pauldhawk/splitflap/docs/goals.md

# project roadmap

PCB Configuration Summary:
-  Display: 48 modules arranged as 4 rows × 12 modules/row
-  Driver Boards: 8 boards (2 per row) × 6 modules/board
-  Daisy Chain: RJ45 connectors with CAT5e/6 cable
-  Motor: NEMA 17 (17HS19-2004S1) with TMC2209 drivers
-  Microstepping: 1/16 (3200 steps/revolution)
-  Current: 1.0A RMS per motor
questions:
1. do you have the abilty to desin new pcb boards? I plan on having them fabricated and need to have a full design 
units:
- new disgn
- motor in the back
- new motor that is stronger
- wire organization
questions:
1. I will be updating the cad files to work with this model. do you have the ability to work with any cad files? like scad or fussion
2. 

I still have a bunch of base questions. This update needs:
1. updating the 3d section for the units (thiking about moving the motor behind the flaps but not sure)
2. 

  Quick Reference for Review

  Key Documents:
  - docs/Firmware_Motor_Selection.md - Firmware implementation (just created)
  - docs/NEMA17_TMC2209_Upgrade.md - Hardware design
  - docs/MotorControlLogic.md - Current motor control explanation

  Core Concepts:
  - Compile-time selection: Motor type chosen at build time via platformio.ini
  - 95% shared code: Only motor control differs between types
  - Zero overhead: Compiler removes unused code paths
  - Backward compatible: Existing 28BYJ-48 systems unaffected

  ---
  I'm Ready for Your Questions!

  Ask me anything about:
  - 🏗️ Architecture: Why this approach? What are the alternatives?
  - 🔧 Implementation: How does the code actually work?
  - 🔌 Hardware: How does firmware talk to TMC2209? Pin assignments?
  - ⚡ Performance: Timing, speed, resource usage?
  - 🧪 Testing: How to verify it works? What could go wrong?
  - 📚 Dependencies: What libraries needed? Tool versions?
  - ⏱️ Timeline: How long will implementation take?
  - 🎯 Scope: What's in phase 1 vs later phases?
  - 🤔 Edge Cases: Mixed systems? Upgrading firmware? Rollback?

  Go ahead - ask your base questions and I'll explain everything in detail!

  pleaser look at hte current cad files. thinking about:
  1. should we move the motor to being the drum (these motors with is veriable so it could simplify things or just make it work with the motor instide.
  2. other deisgn changes that will be needed.
  3. is 3d printing the base way to build the unit or some other method
