pauldhawk/splitflap/3d/redesign/nema17_coupling_hub_preview.png

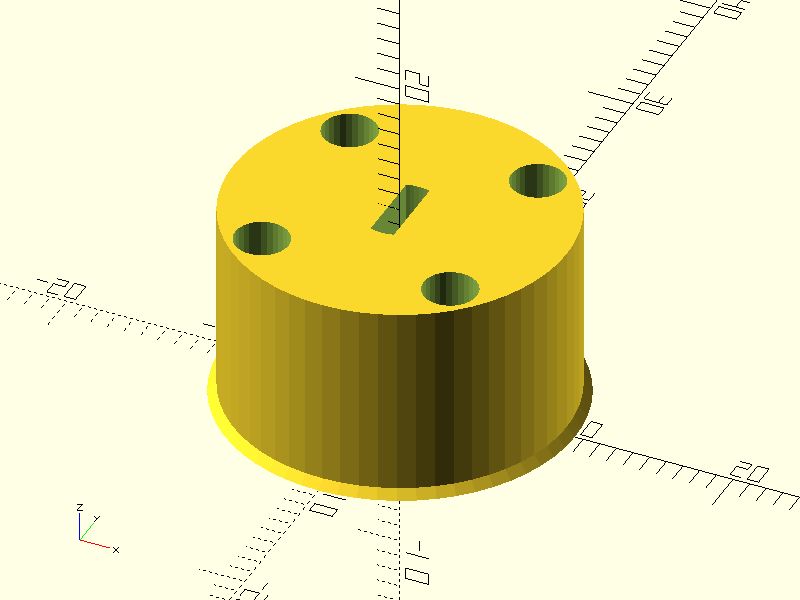
3d/redesign/nema17_coupling_hub_preview.png
