pauldhawk/splitflap/docs/parts.md

Teyleten Robot TMC2209 V2.0 Stepper Motor Driver StepStick 2.5A UART Ultra Silent for Nano SKR V1.3/1.4 Ender 3 Control Board 3D Printer Parts Replace A4988 5pcs

STEPPERONLINE Nema 17 Stepper Motor Bipolar 2A 59Ncm(84oz.in) 48mm Body 4-Lead W/ 1m Cable and Connector Compatible with 3D Printer/CNC

STEPPERONLINE Short Body Nema 17 Bipolar Stepper Motor 1A 22.6oz.in/16Ncm DIY CNC Extruder
