pauldhawk/splitflap/3d/redesign/splitflap_step.STEP

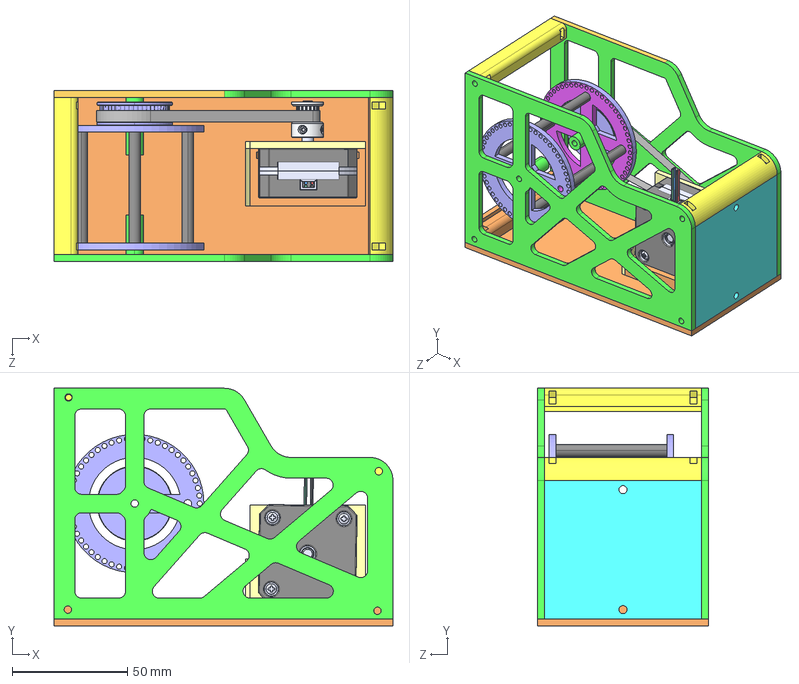
[picture p2: CAD file, 2025-12-31]
3d/redesign/splitflap_step.STEP
147.0 x 103.0 x 74.0 mm
Final
17HS19-2004S1_motor
GT2_16T_____________1
Belt1-6^final_Assembly
