pauldhawk/splitflap/3d/redesign/nema17_coupling_hub.stl

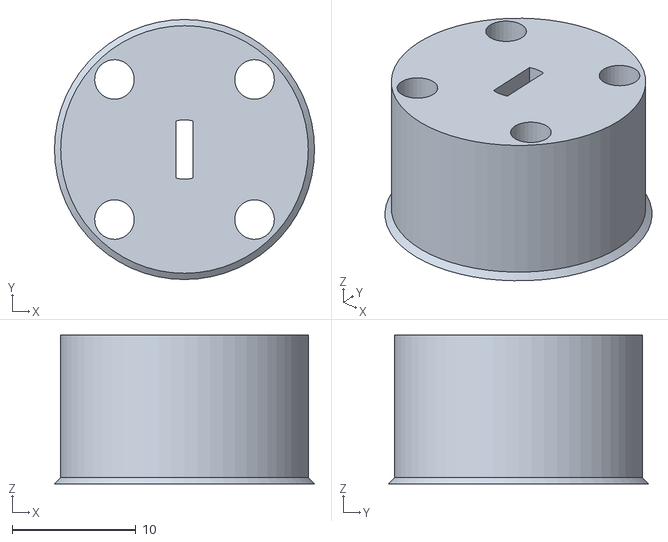
[picture p3: CAD file, 2025-12-31]
3d/redesign/nema17_coupling_hub.stl
21.0 x 21.0 x 12.0
