pauldhawk/splitflap/3d/redesign/assembly.scad

use <lib/hardware.scad>;
