pauldhawk/splitflap/3d/redesign/drum.scad

use <lib/hardware.scad>;
