pauldhawk/splitflap/3d/redesign/frame.scad

use <lib/hardware.scad>;
