pauldhawk/splitflap/3d/redesign/assembly_exploded.png

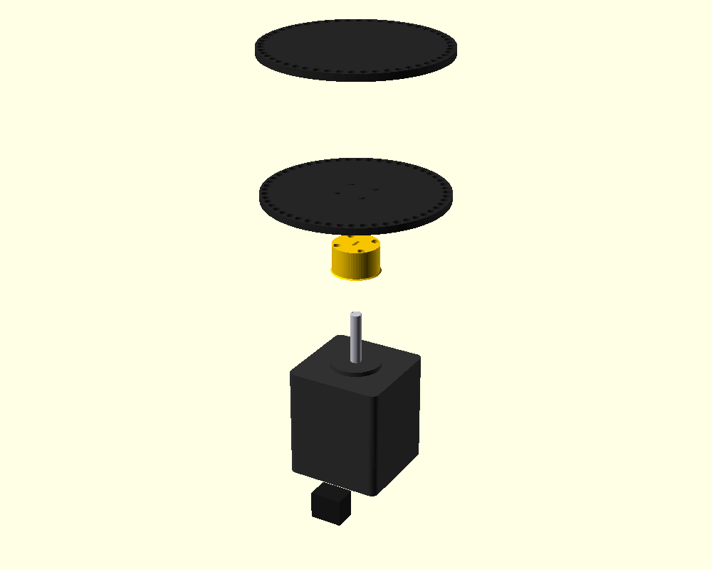
3d/redesign/assembly_exploded.png
