pauldhawk/splitflap/3d/redesign/hub_assembly_view.png

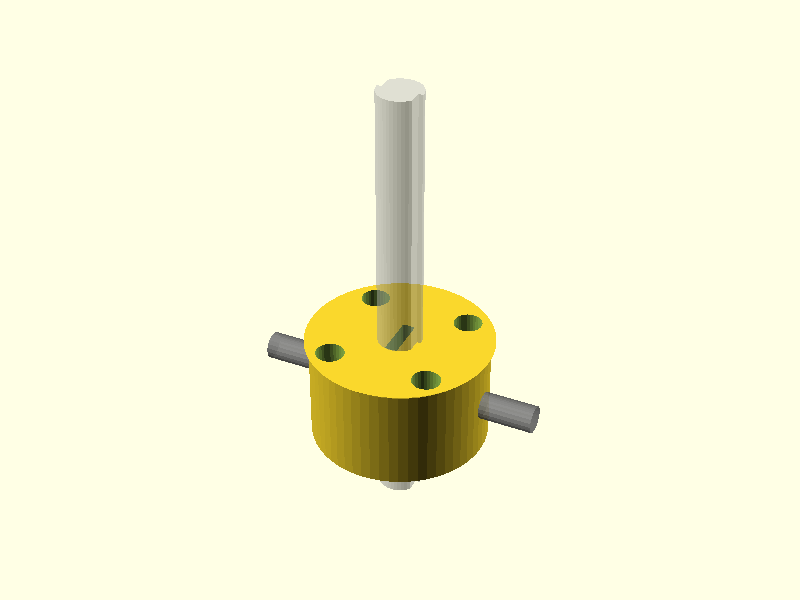
3d/redesign/hub_assembly_view.png
