pauldhawk/splitflap/(commit log)

2025-12-31 ai doc
    [nema17.scad, nema17_assembly_view.scad, nema17_coupling_hub.scad, nema17_coupling_hub.stl, splitflap_step.STEP]
2026-01-01 before working on the prototype
2026-01-01 test firmware working with stepper
2026-01-03 start 3d work
    [assembly.scad, case.scad, constants.scad, drum.scad, fasteners.scad, frame.scad, gears.scad, gt2_pulley.scad]
2026-01-03 cad less sucky
    [constants.scad, drum.scad, motor_mount.scad]
2026-01-03 spoke stubbed ina a way out
    [drum.scad]
2026-01-15 ai work
    [drum.scad]
2026-01-28 moving files around
    [assembly.scad, case.scad, constants.scad, drum.scad, fasteners.scad, frame.scad, gears.scad, gt2_pulley.scad]
